szadil763/guarda-roupa-em-L-com-impressos-3d/docs/previa_pecas.png

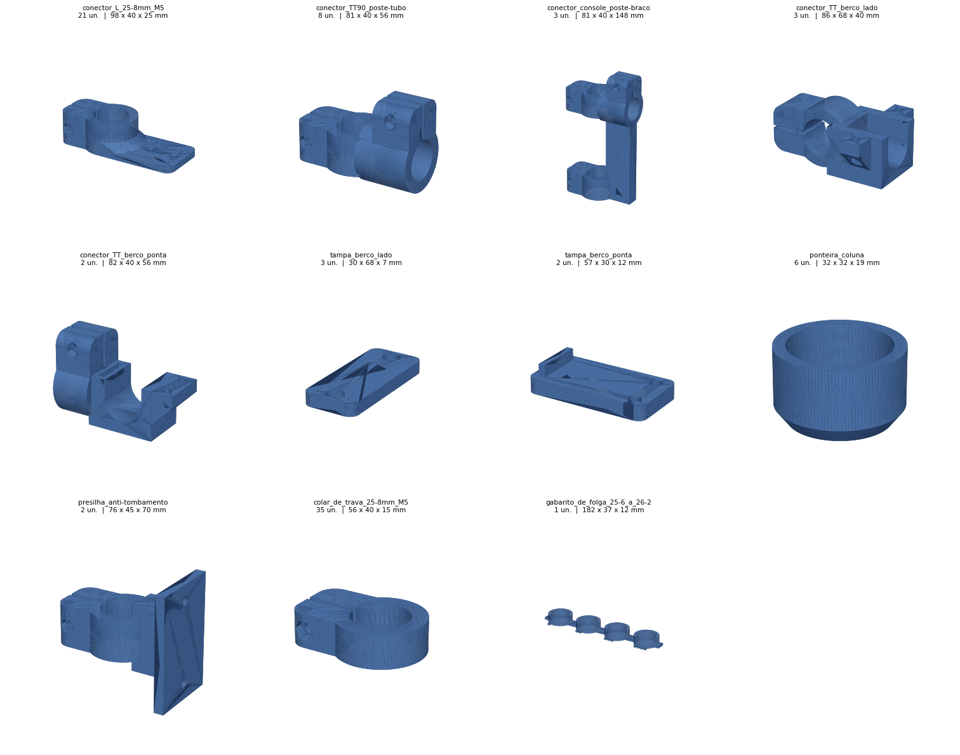
docs/previa_pecas.png
