szadil763/guarda-roupa-em-L-com-impressos-3d/stl/ponteira_coluna.stl

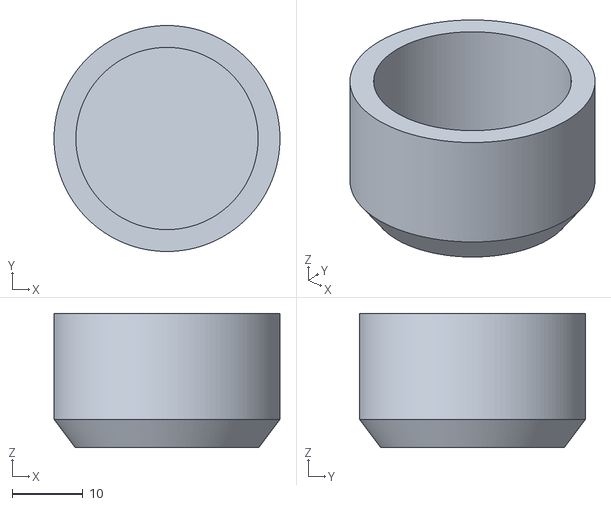
[picture p9: CAD file, 2026-10-14]
stl/ponteira_coluna.stl
32.0 x 32.0 x 19.0
