szadil763/guarda-roupa-em-L-com-impressos-3d/stl/conector_console_poste-braco.stl

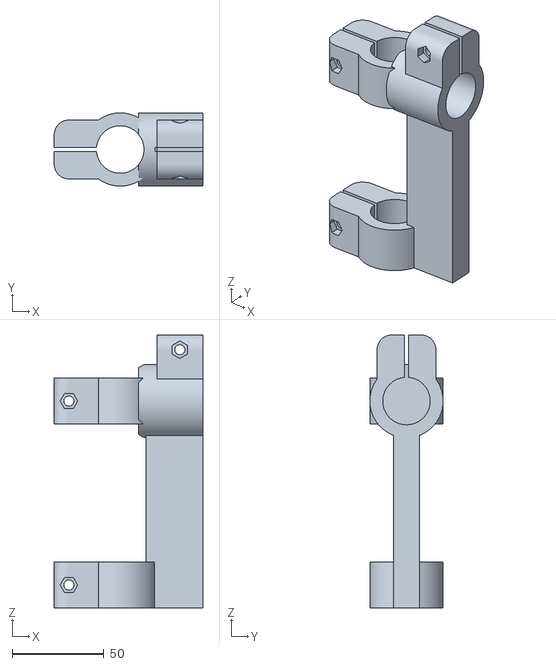
[picture p10: CAD file, 2026-10-14]
stl/conector_console_poste-braco.stl
80.8 x 39.8 x 148.4
