szadil763/guarda-roupa-em-L-com-impressos-3d/stl/tampa_berco_ponta.stl

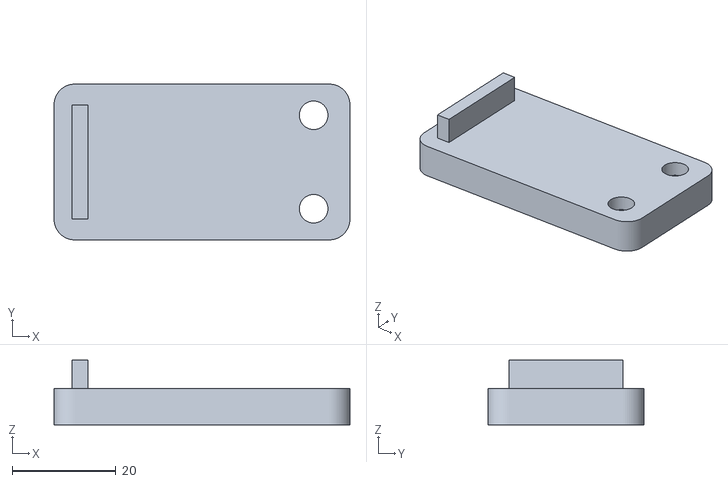
[picture p11: CAD file, 2026-10-14]
stl/tampa_berco_ponta.stl
57.0 x 30.0 x 12.5
