szadil763/guarda-roupa-em-L-com-impressos-3d/stl/tampa_berco_lado.stl

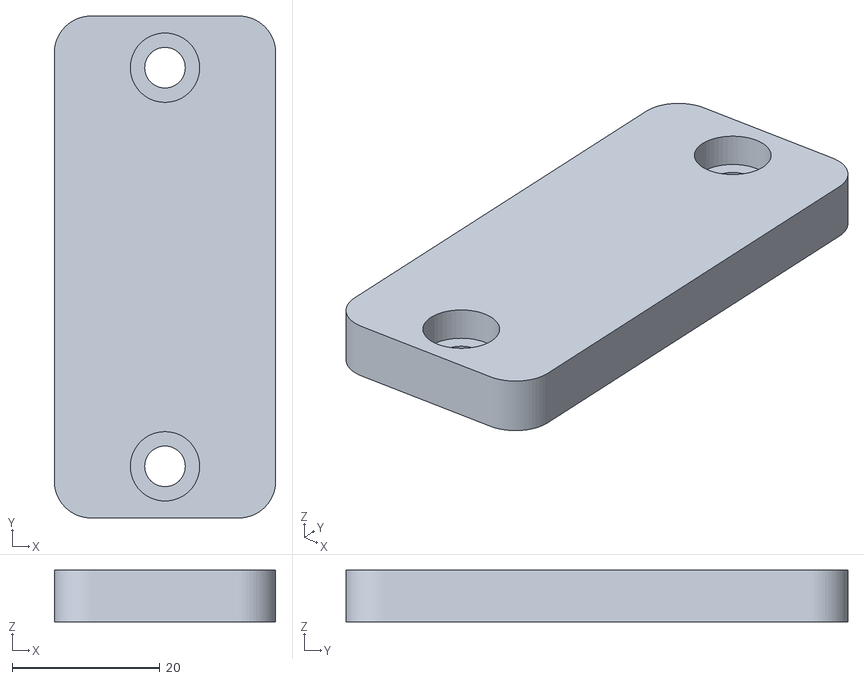
[picture p12: CAD file, 2026-10-14]
stl/tampa_berco_lado.stl
30.0 x 68.0 x 7.00
