szadil763/guarda-roupa-em-L-com-impressos-3d/stl/conector_TT_berco_lado.stl

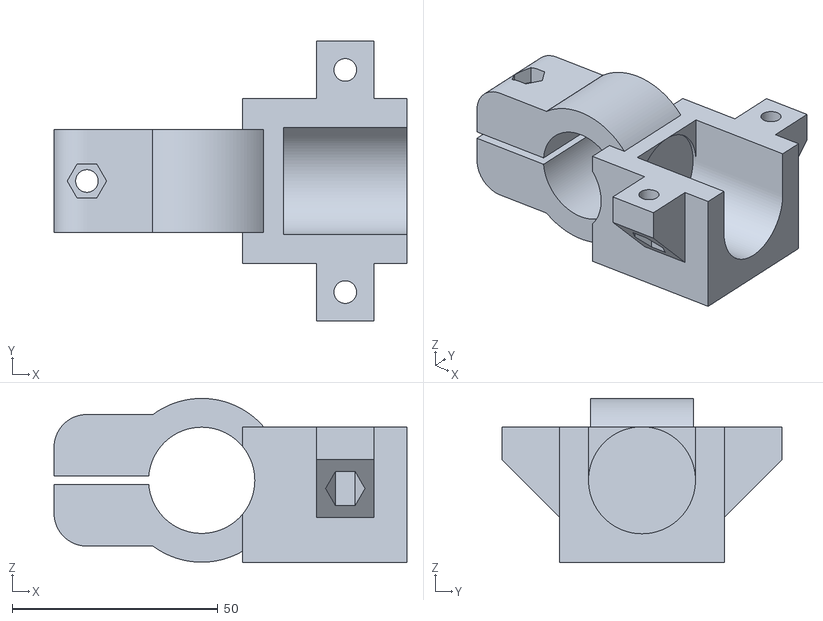
[picture p13: CAD file, 2026-10-14]
stl/conector_TT_berco_lado.stl
85.8 x 68.0 x 39.9
