szadil763/guarda-roupa-em-L-com-impressos-3d/stl/presilha_anti-tombamento.stl

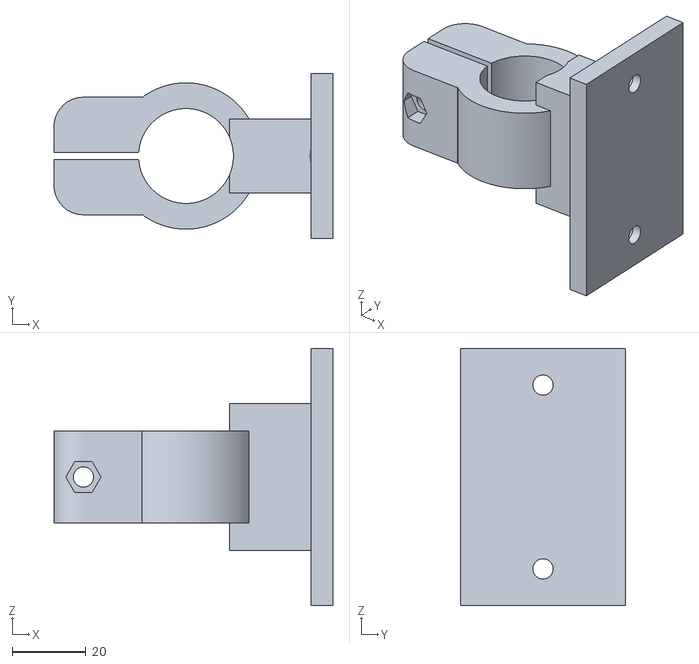
[picture p14: CAD file, 2026-10-14]
stl/presilha_anti-tombamento.stl
75.9 x 45.0 x 70.0
