szadil763/guarda-roupa-em-L-com-impressos-3d/stl/conector_L_25-8mm_M5.stl

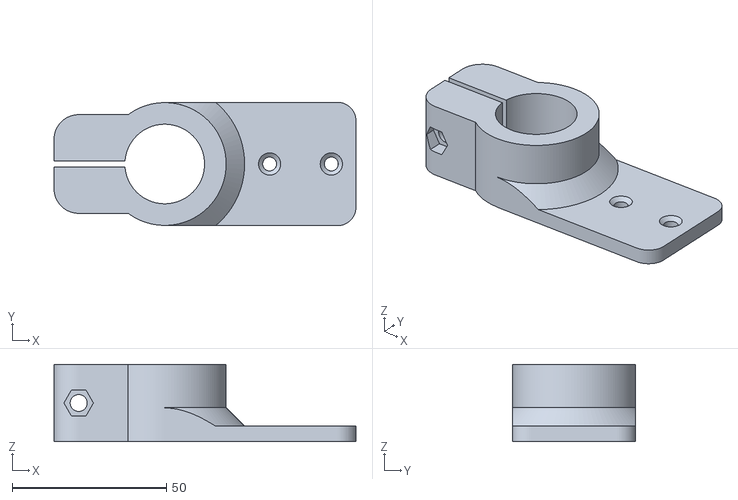
[picture p15: CAD file, 2026-10-14]
stl/conector_L_25-8mm_M5.stl
97.9 x 40.0 x 25.0
