szadil763/guarda-roupa-em-L-com-impressos-3d/stl/conector_TT90_poste-tubo.stl

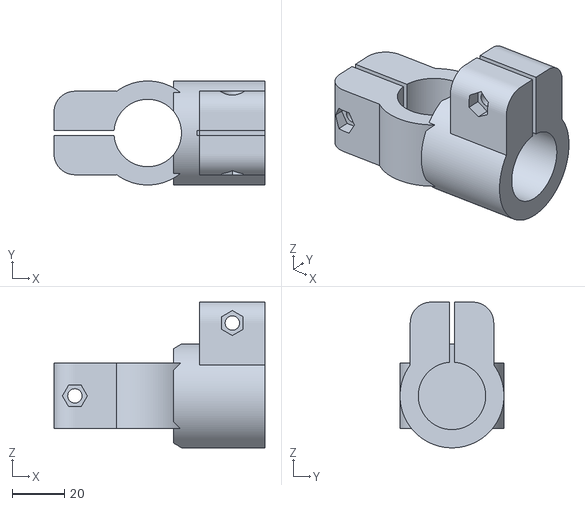
[picture p16: CAD file, 2026-10-14]
stl/conector_TT90_poste-tubo.stl
80.8 x 39.8 x 55.8
