szadil763/guarda-roupa-em-L-com-impressos-3d/stl/conector_TT_berco_ponta.stl

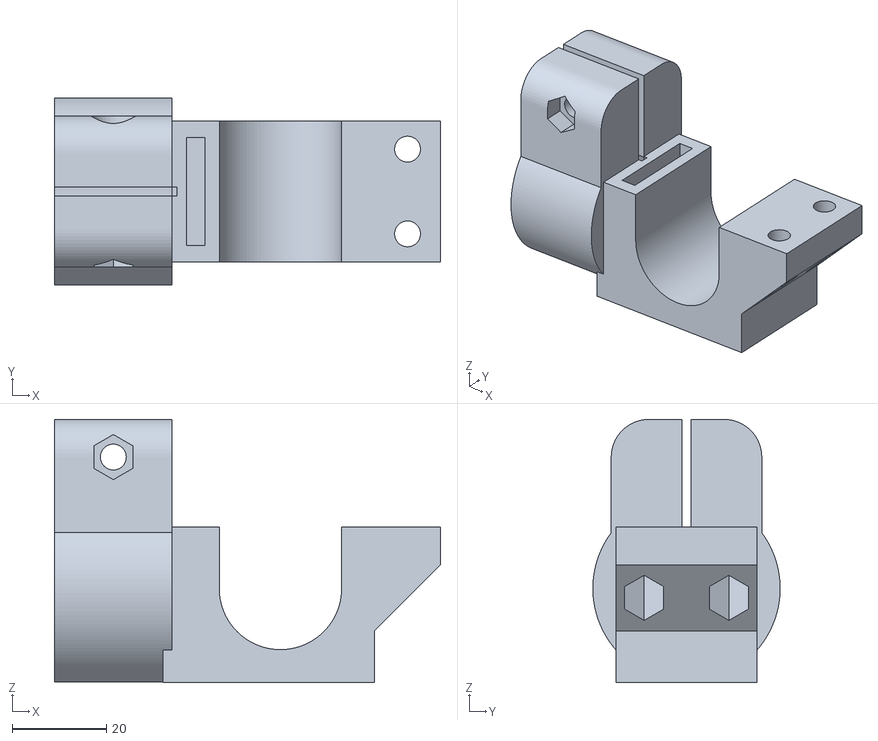
[picture p17: CAD file, 2026-10-14]
stl/conector_TT_berco_ponta.stl
82.0 x 39.8 x 55.9
