szadil763/guarda-roupa-em-L-com-impressos-3d/stl/colar_de_trava_25-8mm_M5.stl

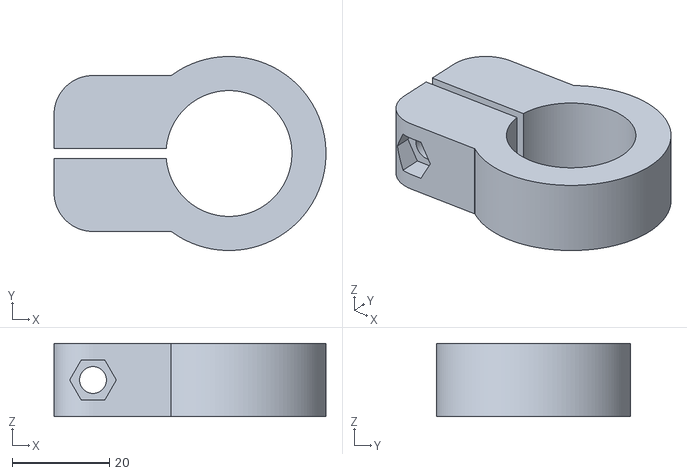
[picture p18: CAD file, 2026-10-14]
stl/colar_de_trava_25-8mm_M5.stl
55.8 x 39.8 x 15.0
