szadil763/guarda-roupa-em-L-com-impressos-3d/stl/gabarito_de_folga_25-6_a_26-2.stl

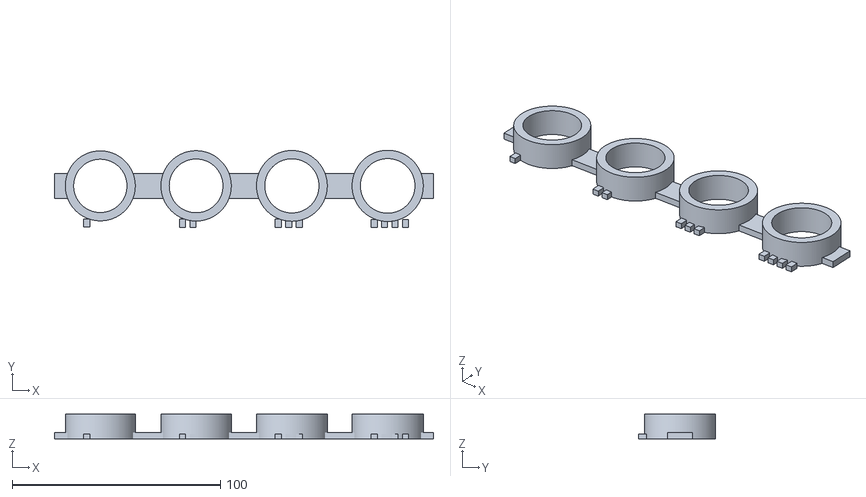
[picture p19: CAD file, 2026-10-14]
stl/gabarito_de_folga_25-6_a_26-2.stl
182.0 x 37.2 x 12.0
